caneryagci/EE_463/hardware_arduino/version2.code.ino

int data_read = A0;
int pwm_pin = 9;
float duty_cycle = 0;
//float degisken = 0;
float inputValue = 0;

void setup() {
  Serial.begin(9600);
  pinMode(pwm_pin,OUTPUT);
  pinMode(data_read,INPUT);
  setPwmFrequency(9, 3); //Sets the pwm output of 6 to around 8 to 9 kHz
}

void setPwmFrequency(int pin, int divisor) {
  byte mode;
  if(pin == 5 || pin == 6 || pin == 9 || pin == 10) {
    switch(divisor) {
      case 1: mode = 0x01; break;
      case 8: mode = 0x02; break;
      case 64: mode = 0x03; break;
      case 256: mode = 0x04; break;
      case 1024: mode = 0x05; break;
      default: return;
    }
    if(pin == 5 || pin == 6) {
      TCCR0B = TCCR0B & 0b11111000 | mode;
    } else {
      TCCR1B = TCCR1B & 0b11111000 | mode;
    }
  } else if(pin == 3 || pin == 11) {
    switch(divisor) {
      case 1: mode = 0x01; break;
      case 8: mode = 0x02; break;
      case 32: mode = 0x03; break;
      case 64: mode = 0x04; break;
      case 128: mode = 0x05; break;
      case 256: mode = 0x06; break;
      case 1024: mode = 0x07; break;
      default: return;
    }
    TCCR2B = TCCR2B & 0b11111000 | mode;
  }
}

void loop(){

   inputValue = analogRead(data_read);
   analogWrite(pwm_pin, inputValue/4);
   duty_cycle = inputValue / 1024 *100;
   Serial.print("Duty Cycle = ");
   Serial.println(duty_cycle);
}
