caneryagci/EE_463/(commit log)

2017-12-26 Simulation for the proper capacitor value was done
2018-01-20 arduino referance codes url's are added
2018-01-20 hall sensor rpm measure kodu
    hall sensorden gelen datada iki rising edge arası sureden rpm i print eden kod
2018-01-20 arduino codes are added for pwm generation
2018-01-24 test results
    voltage and speed test data uploaded.
